RJariwala/SynchroKin_Wireless/README.md

# SynchroKin_Wireless
Untethered full-body kinematics tracking system using ESP32, BNO055, and Unity.
