RJariwala/SynchroKin_Wireless/Unity_Environment/README.md

Unity_Environment_Script.cs contains the detailed, fully commented code for the Avatar in UNITY. Please download and view Adding_Unity_Environment.pdf for instructions on how to add the environment to your Unity Hub

buttonhoverscale.cs contains code for buttons to change size when the cursor hovers over them.
