RJariwala/SynchroKin_Wireless/Unity_Environment/Adding_Unity_Environment.pdf

SynchroKin Unity Setup Guide

# SynchroKin Unity Environment

## Download & Setup Guide

## 1 Quick Start: Ready-to-Use Application

If you only want to run the SynchroKin clinical dashboard without editing any code or 3D models, you do not need to install Unity. You can simply download the pre-compiled executable.

1. Navigate to the SynchroKin GitHub Releases page at: https://github.com/RJariwala/SynchroKin_Wireless/releases
2. Under the Latest release tag (e.g., v1.0.0), look for the Assets section.
3. Click on Synchrokin.zip (approx. 46.7 MB) to download the ready-to-use app.
4. Extract the ZIP folder to your computer.
5. Open the extracted folder and double-click the .exe file to launch the dashboard. (Make sure your Master ESP32 is plugged in via USB before launching!)

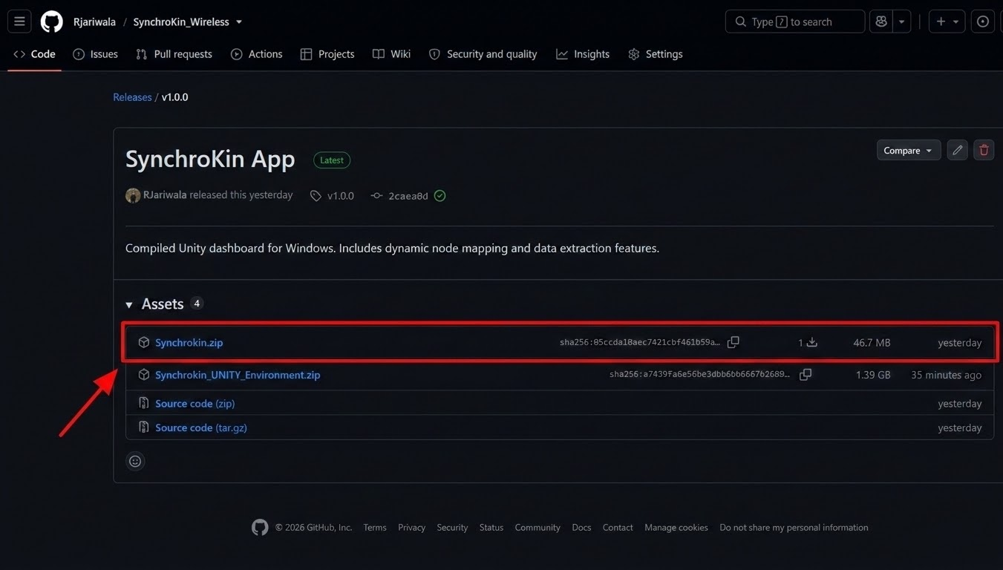
[picture p3: figure]

Figure 1: Highlighting the Synchrokin.zip file for users who just want to run the application.

## 2 Downloading the Project Source (For Developers)

To modify the SynchroKin 3D environment, edit the dashboard C# scripts, or compile a new version of the application, you need to download the full Unity project source code.

### 2.1 Locating the Source Release

1. On the same GitHub Releases page mentioned above, look under the Assets section.
2. Click on Synchrokin UNITY Environment.zip to begin the download.
3. Note: This file is approximately 1.39 GB because it contains all 3D assets, textures, and package manifests required for the development environment.

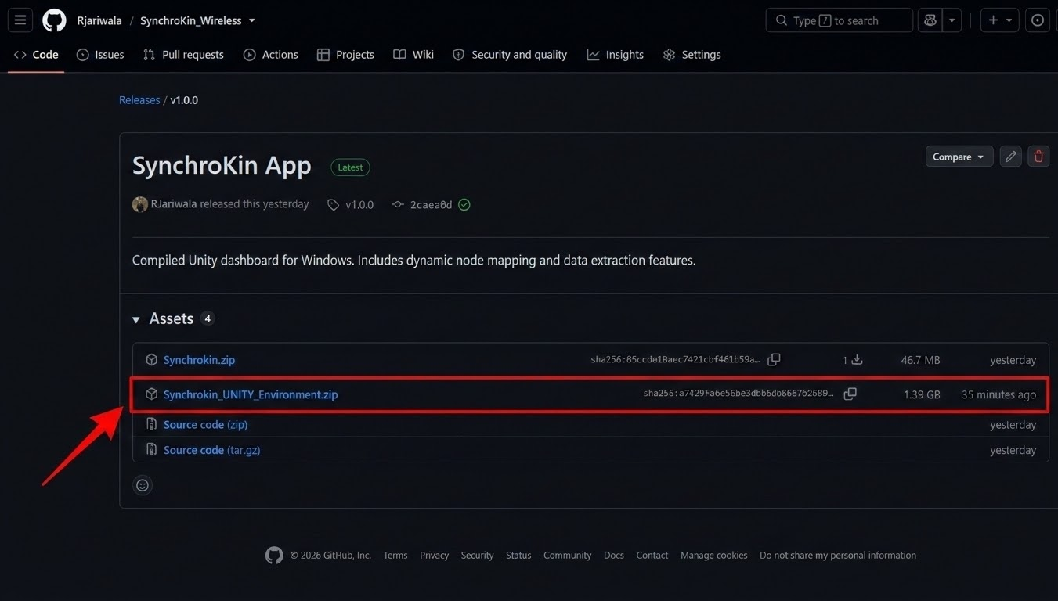
[picture p4: figure]

Figure 2: The GitHub Releases page showing the Unity Environment zip file required for developers.

## 3 Extracting the Development Files

Unity projects cannot be opened or run while they are still inside a compressed ZIP folder.

1. Locate the Synchrokin UNITY Environment.zip file in your Downloads folder.
2. Right-click the file and select Extract All (Windows) or double-click it to unzip (Mac).
3. Choose a permanent, easily accessible location for the folder, such as your Documents or a dedicated Unity Projects directory.

## 4 Adding the Project to Unity Hub

Once the folder is extracted, you must link it to Unity Hub so the Unity Editor can manage its dependencies and versioning.

1. Open Unity Hub on your computer.
2. Navigate to the Projects tab on the left-hand menu.
3. In the top right corner, click the Add button (or click the small arrow next to it and select Add project from disk).

4. A file explorer window will open. Navigate to the folder you extracted in the previous step, click on it once to highlight it, and click Select Folder.

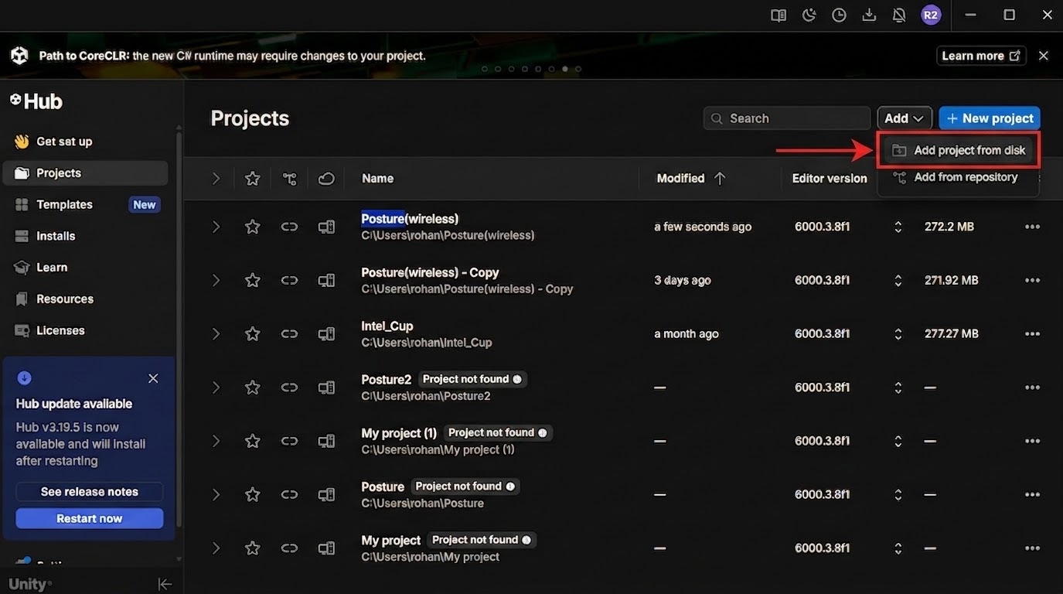
[picture p5: figure]

Figure 3: Adding the extracted project folder into the Unity Hub dashboard. EDITOR VER-SION IS 6000.3.8f1

## 5 First Launch & Rebuilding

Now that the project is listed in your Unity Hub, you are ready to open it.

1. Click on the newly added SynchroKin project in your Unity Hub list.
2. Warning regarding Editor Versions: Ensure you are opening the project with the same Unity version it was built on (check the Editor Version column). If Unity warns you about a version mismatch, installing the matching LTS version via Unity Hub is highly recommended to prevent broken scripts or UI elements.
3. Initial Rebuild Time: The first time you open this project, Unity will take several minutes to completely rebuild the Library folder from scratch. The screen may look frozen on the ”Resolving Packages” or ”Importing Assets” window. This is completely normal—do not force close the application.

Once the progress bar finishes, the Unity Editor will open directly to the SynchroKin dashboard scene, exactly as it was configured before upload!
