RJariwala/SynchroKin_Wireless/(list of files, cad)

Other CAD files:
3D_Model_and_Module_Replication/CAD_Files/Limb_module_1.ipt
3D_Model_and_Module_Replication/CAD_Files/limb_cover.ipt
